CounterPillow/achterart/achterart/achterart.kicad_pcb

## KiCad design achterart/achterart.kicad_pcb (2022-11-14)

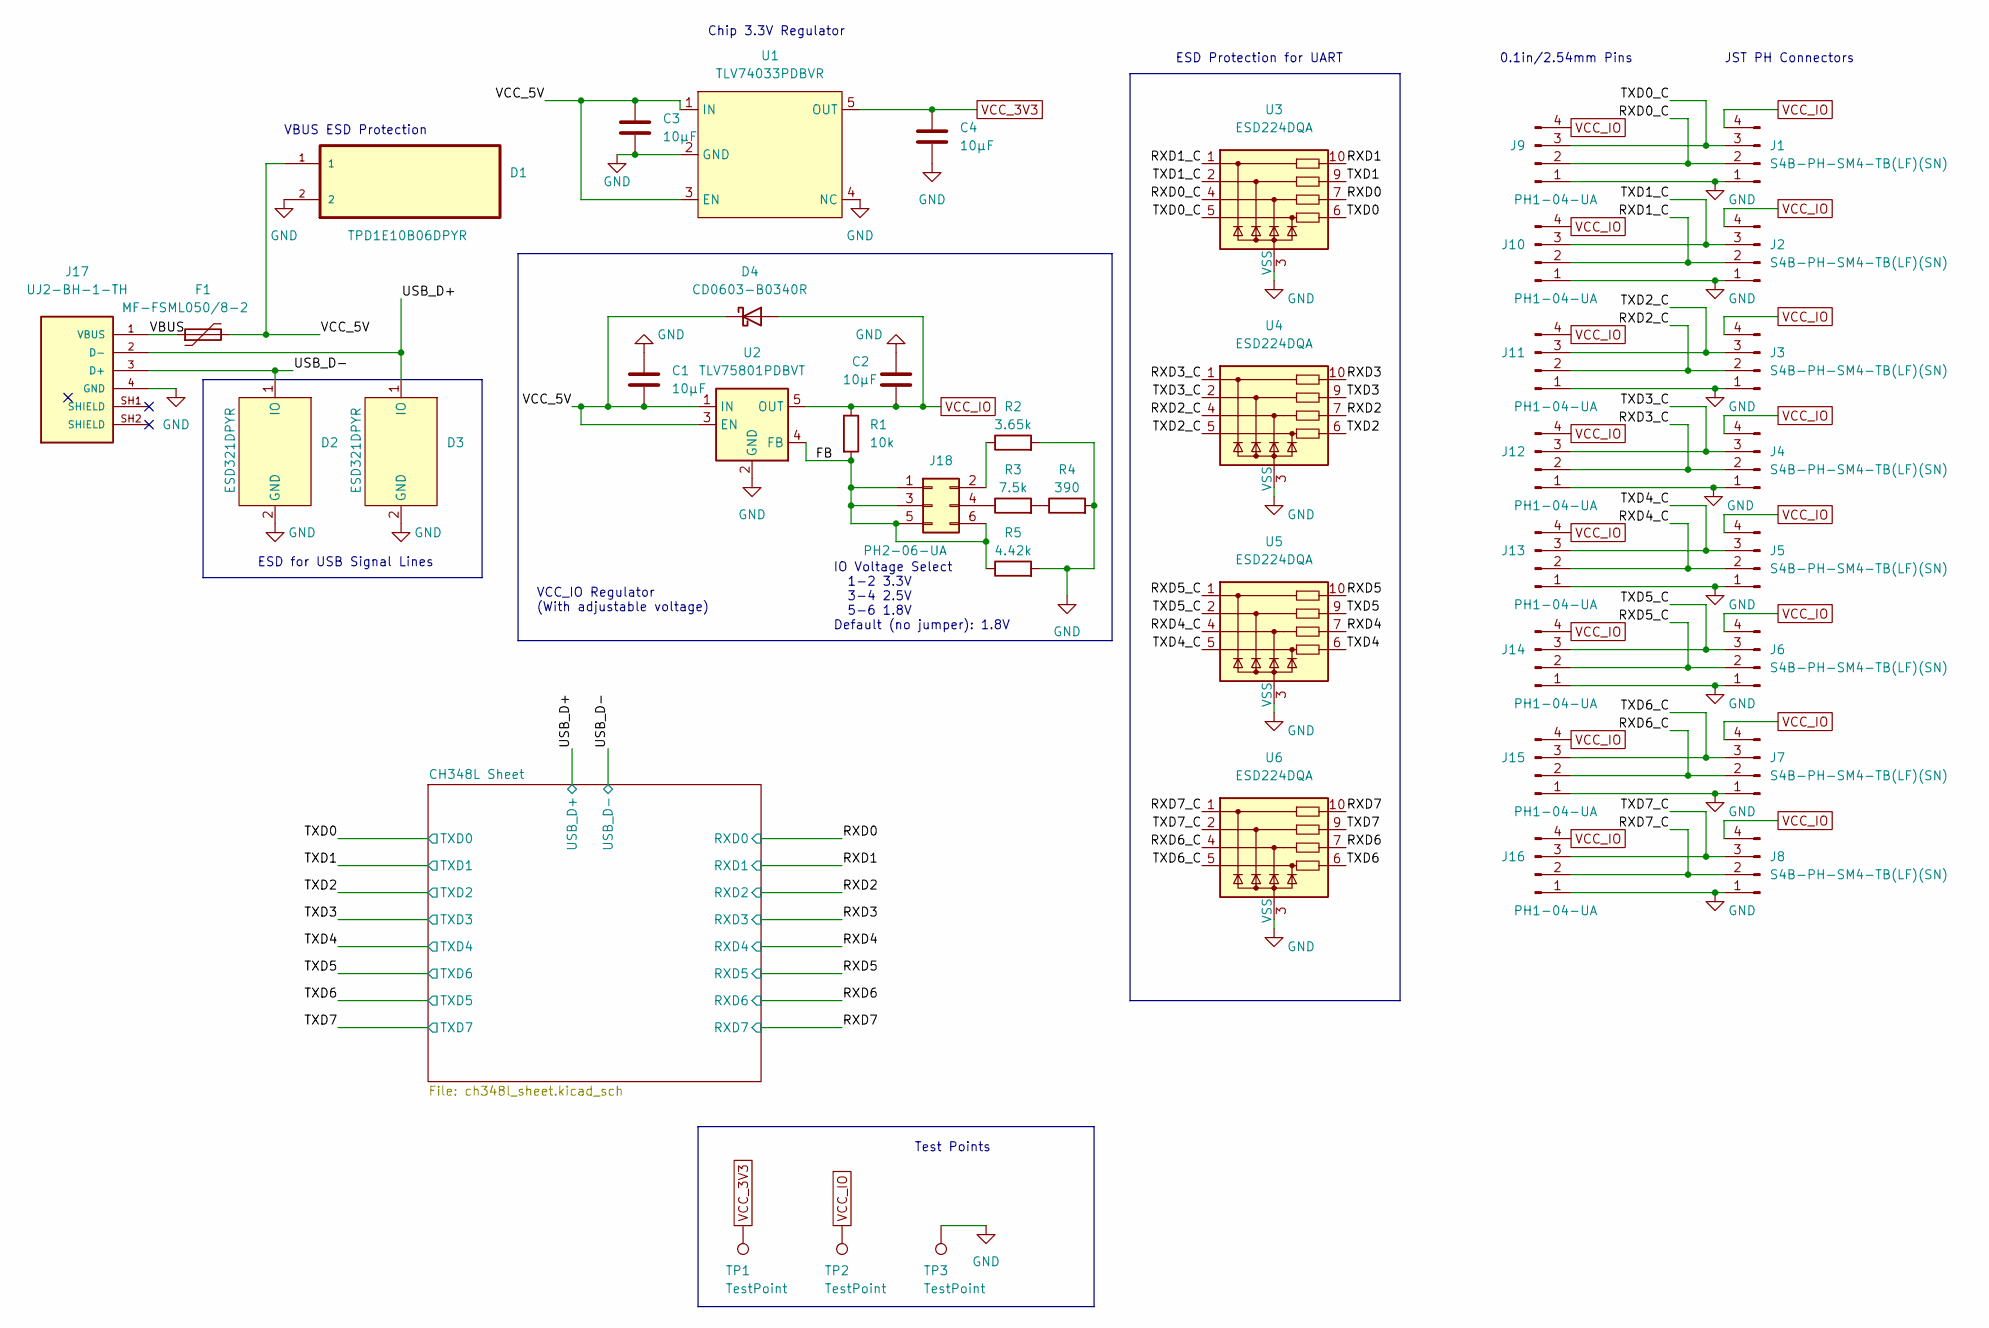
[picture p1: schematic achterart.kicad_sch]

Parts:
C1, C2, C3, C4: 10µF; C_0603_1608Metric; MPN 10uF X7R 0603
D1: TPD1E10B06DPYR; DIO_TPD1E05U06DPYR; MPN TPD1E10B06DPYR
D2, D3: ESD321DPYR; DIO_TPD1E05U06DPYR; MPN ESD321DPYR
D4: CD0603-B0340R; D_0603_1608Metric; MPN CD0603-B0340R
F1: MF-FSML050/8-2; Fuse_0603_1608Metric; MPN MF-FSML050/8-2
J1, J2, J3, J4, J5, J6, J7, J8: S4B-PH-SM4-TB(LF)(SN); JST_PH_S4B-PH-SM4-TB_1x04-1MP_P2.00mm_Horizontal; MPN S4B-PH-SM4-TB(LF)(SN)
J9, J10, J11, J12, J13, J14, J15, J16: PH1-04-UA; PinHeader_1x04_P2.54mm_Vertical; MPN PH1-04-UA; LCSC Part # C706876
J17: UJ2-BH-1-TH; CUI_UJ2-BH-1-TH; PART_REV 1.0
J18: PH2-06-UA; PinHeader_2x03_P2.54mm_Vertical; MPN PH2-06-UA; LCSC Part # C706893
R1: 10k; R_0603_1608Metric; MPN 10k 1% 0603
R2: 3.65k; R_0603_1608Metric; MPN 3.65k 1% 0603
R3: 7.5k; R_0603_1608Metric; MPN 7.5k 1% 0603
R4: 390; R_0603_1608Metric; MPN 390 1% 0603
R5: 4.42k; R_0603_1608Metric; MPN 4.42k 1% 0603
TP1, TP2, TP3: TestPoint; TestPoint_Plated_Hole_D2.0mm
U1: TLV74033PDBVR; SOT95P280X145-5N; MPN TLV74033PDBVR
U2: TLV75801PDBVT; SOT-23-5; MPN TLV75801PDBVT
U3, U4, U5, U6: ESD224DQA; Diodes_UDFN-10_1.0x2.5mm_P0.5mm; MPN ESD224DQAR

Connections:
/FB: J18.1, J18.3, J18.5, J18.6, R1.2, R5.1, U2.4 (FB)
/RXD0: U3.7; also elsewhere on the board
/RXD0_C: J1.2, J9.2, U3.4
/RXD1: U3.10; also elsewhere on the board
/RXD1_C: J2.2, J10.2, U3.1
/RXD2: U4.7; also elsewhere on the board
/RXD2_C: J3.2, J11.2, U4.4
/RXD3: U4.10; also elsewhere on the board
/RXD3_C: J4.2, J12.2, U4.1
/RXD4: U5.7; also elsewhere on the board
/RXD4_C: J5.2, J13.2, U5.4
/RXD5: U5.10; also elsewhere on the board
/RXD5_C: J6.2, J14.2, U5.1
/RXD6: U6.7; also elsewhere on the board
/RXD6_C: J7.2, J15.2, U6.4
/RXD7: U6.10; also elsewhere on the board
/RXD7_C: J8.2, J16.2, U6.1
/TXD0: U3.6; also elsewhere on the board
/TXD0_C: J1.3, J9.3, U3.5
/TXD1: U3.9; also elsewhere on the board
/TXD1_C: J2.3, J10.3, U3.2
/TXD2: U4.6; also elsewhere on the board
/TXD2_C: J3.3, J11.3, U4.5
/TXD3: U4.9; also elsewhere on the board
/TXD3_C: J4.3, J12.3, U4.2
/TXD4: U5.6; also elsewhere on the board
/TXD4_C: J5.3, J13.3, U5.5
/TXD5: U5.9; also elsewhere on the board
/TXD5_C: J6.3, J14.3, U5.2
/TXD6: U6.6; also elsewhere on the board
/TXD6_C: J7.3, J15.3, U6.5
/TXD7: U6.9; also elsewhere on the board
/TXD7_C: J8.3, J16.3, U6.2
/USB_D+: D3.1 (IO), J17.2 (D-); also elsewhere on the board
/USB_D-: D2.1 (IO), J17.3 (D+); also elsewhere on the board
/VBUS: F1.1, J17.1 (VBUS)
/VCC_5V: C1.2, C3.1, D1.1, D4.1 (K), F1.2, U1.1 (IN), U1.3 (EN), U2.1 (IN), U2.3 (EN); also elsewhere on the board
GND: C1.1, C2.1, C3.2, C4.2, D1.2, D2.2 (GND), D3.2 (GND), J1.1, J2.1, J3.1, J4.1, J5.1, J6.1, J7.1, J8.1, J9.1, J10.1, J11.1, J12.1, J13.1, J14.1, J15.1, J16.1, J17.4 (GND), R2.2, R4.2, R5.2, TP3.1, U1.2 (GND), U1.4 (NC), U2.2 (GND), U3.3 (VSS), U3.8 (VSS), U4.3 (VSS), U4.8 (VSS), U5.3 (VSS), U5.8 (VSS), U6.3 (VSS), U6.8 (VSS); also elsewhere on the board
unnamed: J18.2, R2.1
unnamed: J18.4, R3.1
unnamed: R3.2, R4.1
VCC_3V3: C4.1, TP1.1, U1.5 (OUT); also elsewhere on the board
VCC_IO: C2.2, D4.2 (A), J1.4, J2.4, J3.4, J4.4, J5.4, J6.4, J7.4, J8.4, J9.4, J10.4, J11.4, J12.4, J13.4, J14.4, J15.4, J16.4, R1.1, TP2.1, U2.5 (OUT); also elsewhere on the board

Notes on the sheet:
ESD for USB Signal Lines
VBUS ESD Protection
VCC_IO Regulator (With adjustable voltage)
0.1in/2.54mm Pins
JST PH Connectors
IO Voltage Select 1-2 3.3V 3-4 2.5V 5-6 1.8V Default (no jumper): 1.8V
Chip 3.3V Regulator
ESD Protection for UART
Test Points

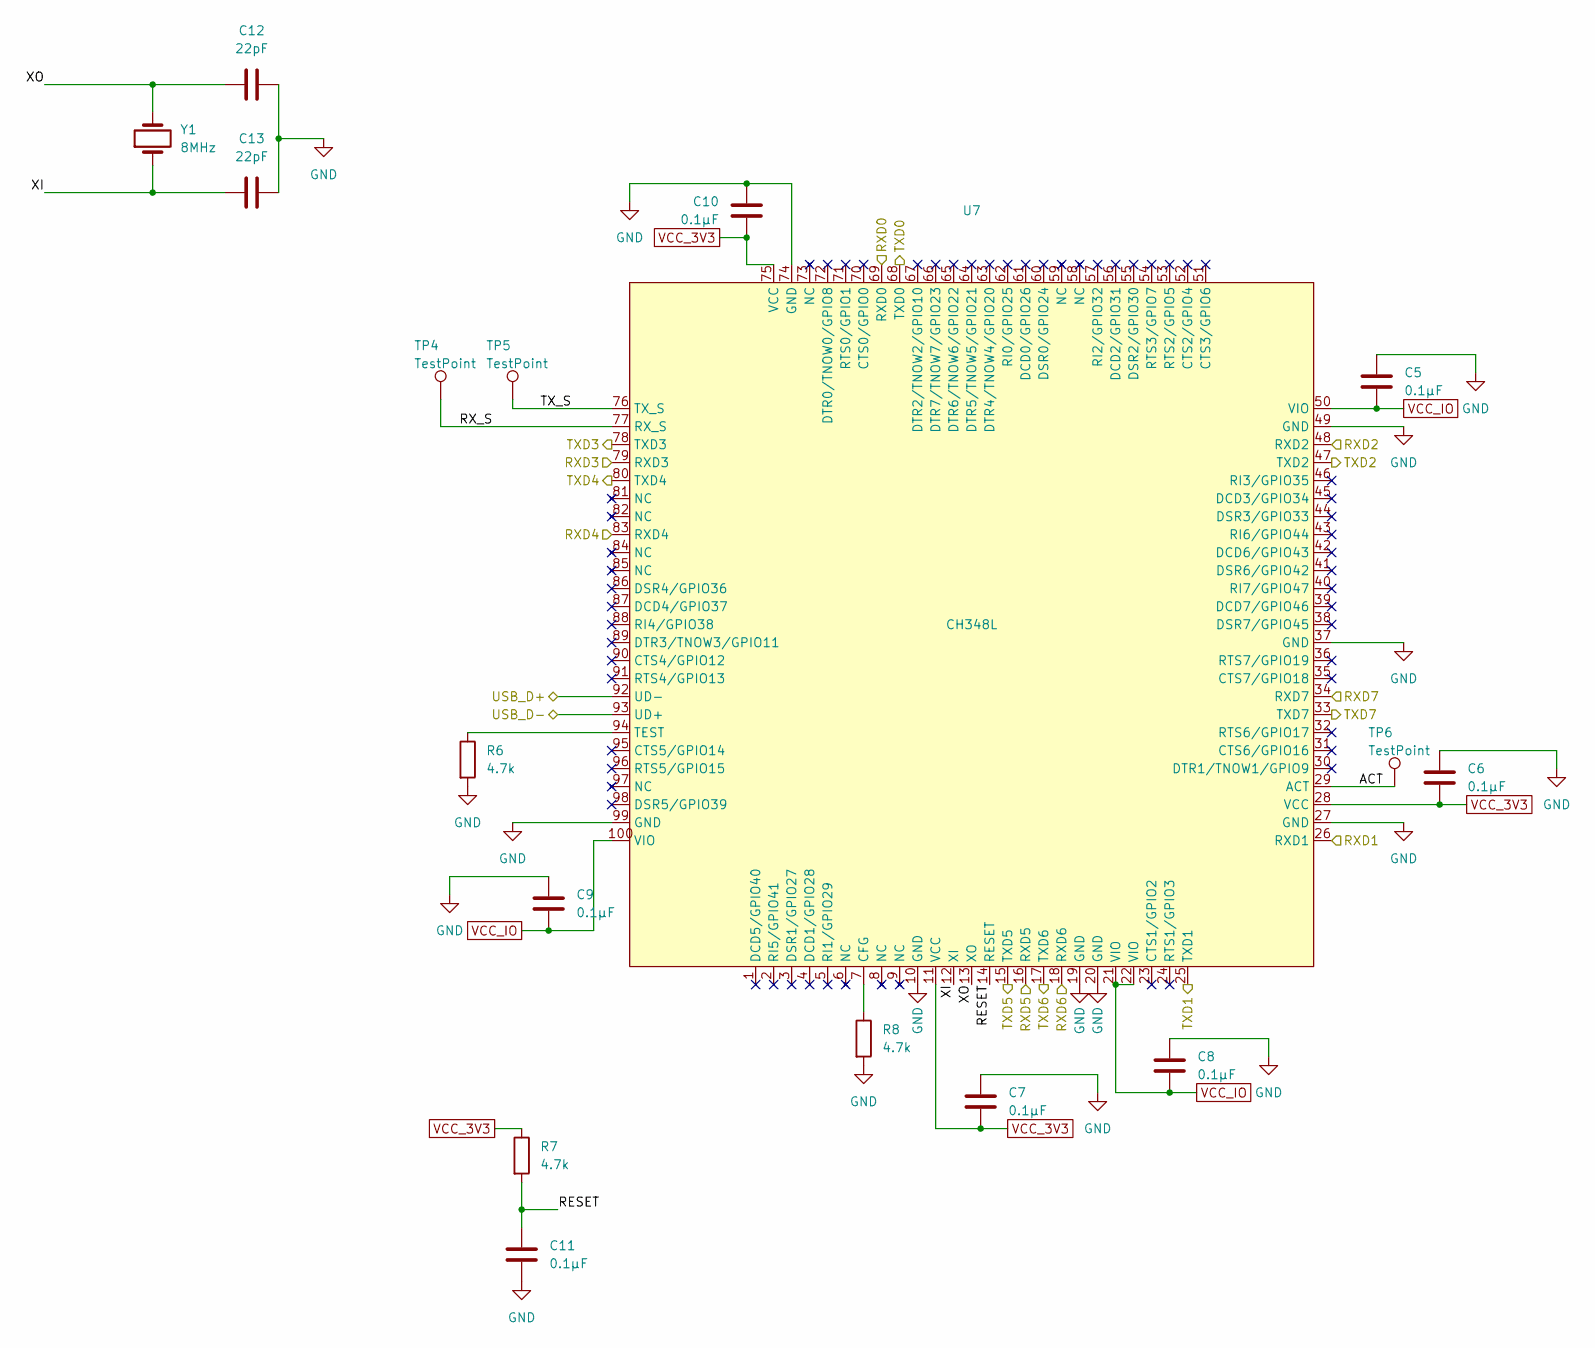
[picture p2: schematic ch348l_sheet.kicad_sch]

Parts:
C5, C6, C7, C8, C9, C10, C11: 0.1µF; C_0603_1608Metric; MPN 0.1uF 0603
C12, C13: 22pF; C_0603_1608Metric; MPN 251R14S220JV4T; LCSC Part # C2168905
R6, R7, R8: 4.7k; R_0603_1608Metric; MPN 4.7k 0603
TP4, TP5, TP6: TestPoint; TestPoint_Plated_Hole_D2.0mm
U7: CH348L; LQFP-100_14x14mm_P0.5mm; MPN CH348L; LCSC Part # C2979160
Y1: 8MHz; Crystal_SMD_HC49-SD_HandSoldering; MPN ATS080BSM-1E

Connections:
/CH348L Sheet/ACT: TP6.1, U7.29 (ACT)
/CH348L Sheet/RESET: C11.1, R7.2, U7.14 (RESET)
/CH348L Sheet/RX_S: TP4.1, U7.77 (RX_S)
/CH348L Sheet/TX_S: TP5.1, U7.76 (TX_S)
/CH348L Sheet/XI: C13.1, U7.12 (XI), Y1.1
/CH348L Sheet/XO: C12.1, U7.13 (XO), Y1.2
/RXD0: U7.69 (RXD0); also elsewhere on the board
/RXD1: U7.26 (RXD1); also elsewhere on the board
/RXD2: U7.48 (RXD2); also elsewhere on the board
/RXD3: U7.79 (RXD3); also elsewhere on the board
/RXD4: U7.83 (RXD4); also elsewhere on the board
/RXD5: U7.16 (RXD5); also elsewhere on the board
/RXD6: U7.18 (RXD6); also elsewhere on the board
/RXD7: U7.34 (RXD7); also elsewhere on the board
/TXD0: U7.68 (TXD0); also elsewhere on the board
/TXD1: U7.25 (TXD1); also elsewhere on the board
/TXD2: U7.47 (TXD2); also elsewhere on the board
/TXD3: U7.78 (TXD3); also elsewhere on the board
/TXD4: U7.80 (TXD4); also elsewhere on the board
/TXD5: U7.17 (TXD6); also elsewhere on the board
/TXD6: U7.15 (TXD5); also elsewhere on the board
/TXD7: U7.33 (TXD7); also elsewhere on the board
/USB_D+: U7.92 (UD-); also elsewhere on the board
/USB_D-: U7.93 (UD+); also elsewhere on the board
GND: C5.1, C6.1, C7.1, C8.1, C9.1, C10.1, C11.2, C12.2, C13.2, R6.2, R8.2, U7.10 (GND), U7.19 (GND), U7.20 (GND), U7.27 (GND), U7.37 (GND), U7.49 (GND), U7.74 (GND), U7.99 (GND); also elsewhere on the board
unnamed: R6.1, U7.94 (TEST)
unnamed: R8.1, U7.7 (CFG)
VCC_3V3: C6.2, C7.2, C10.2, R7.1, U7.11 (VCC), U7.28 (VCC), U7.75 (VCC); also elsewhere on the board
VCC_IO: C5.2, C8.2, C9.2, U7.21 (VIO), U7.22 (VIO), U7.50 (VIO), U7.100 (VIO); also elsewhere on the board

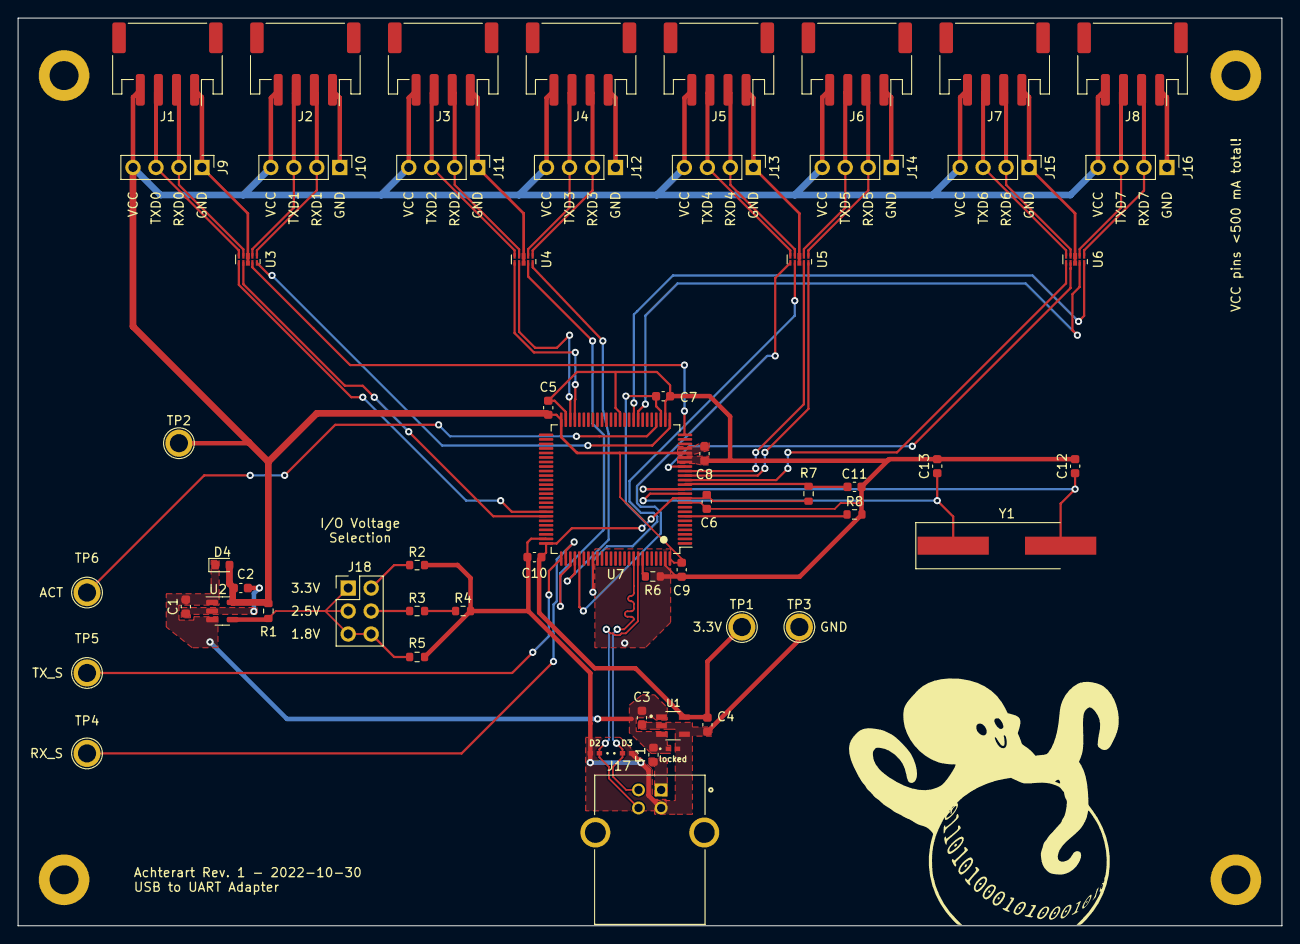
[picture p3: board achterart.kicad_pcb from above]

Board: 2 copper layers, 139.7 x 100.3 mm, 58 parts (0 on the bottom side), 51 nets.

Other parts of the board:
locked: TPD1E10B06DPYR; DIO_TPD1E05U06DPYR

Their connections:
/VCC_5V: locked.1; also elsewhere on the board
GND: locked.2; also elsewhere on the board
