CounterPillow/achterart/(commit log)

2022-10-31 Add JST 3d model
    Pretty sure I can't distribute it, so it's just gonna be useless
    to everyone not on my computer.
    [achterart.kicad_pcb]
2022-11-14 Add some more measurements on the user drawings layer
    [achterart.kicad_pcb]
